hyunsoo-Oh/Gimbal-CAM-Drone/Schematic/bms/bms_schematic.pdf

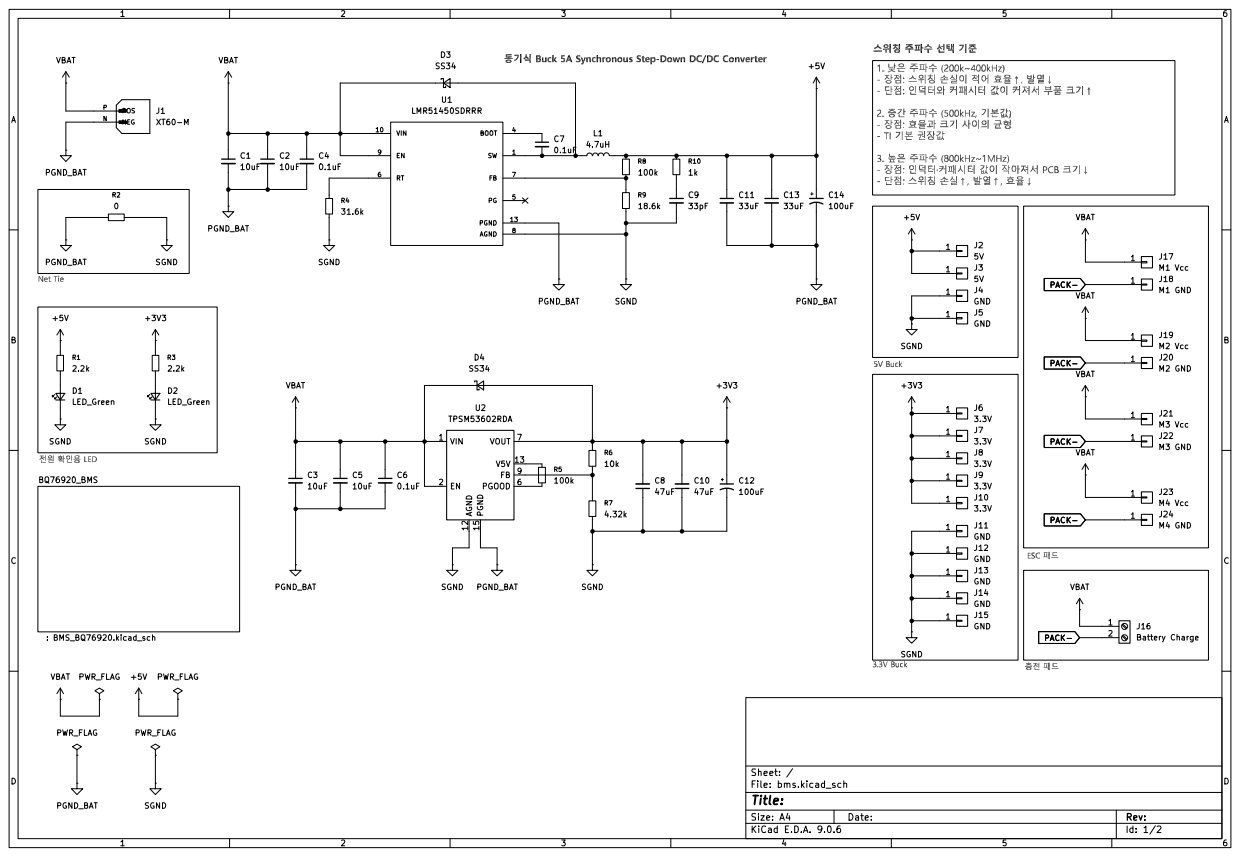
[picture p1: page 1]

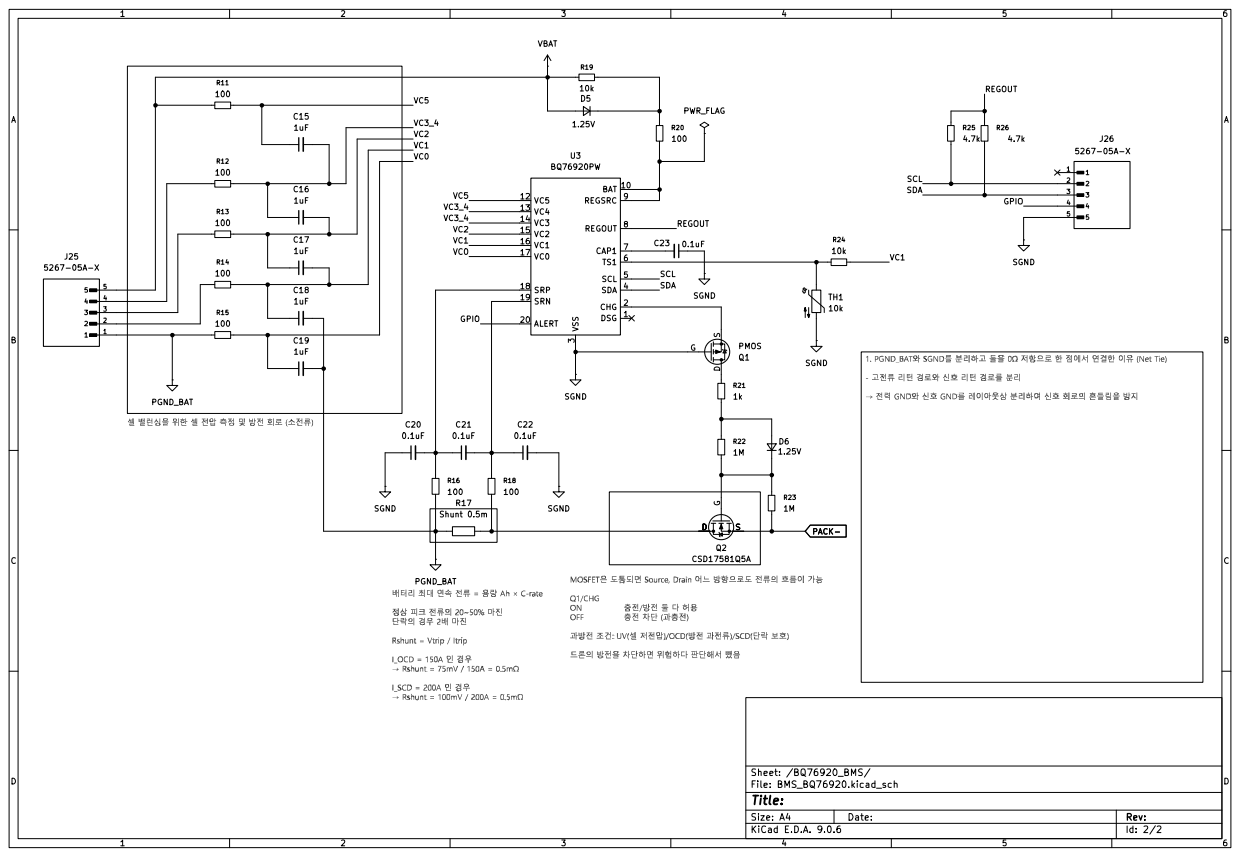
[picture p2: page 2]
