hyunsoo-Oh/Gimbal-CAM-Drone/Module/drone-module/drone-module.ioc

Mcu.UserName=STM32H743VITx
PA4.Signal=GPIO_Output
PA5.Signal=SPI1_SCK
PA6.Signal=SPI1_MISO
PA7.Signal=SPI1_MOSI
